dnd-global/hardware-esp32-ethernet/docs/img/3d-cheo-sau.jpg

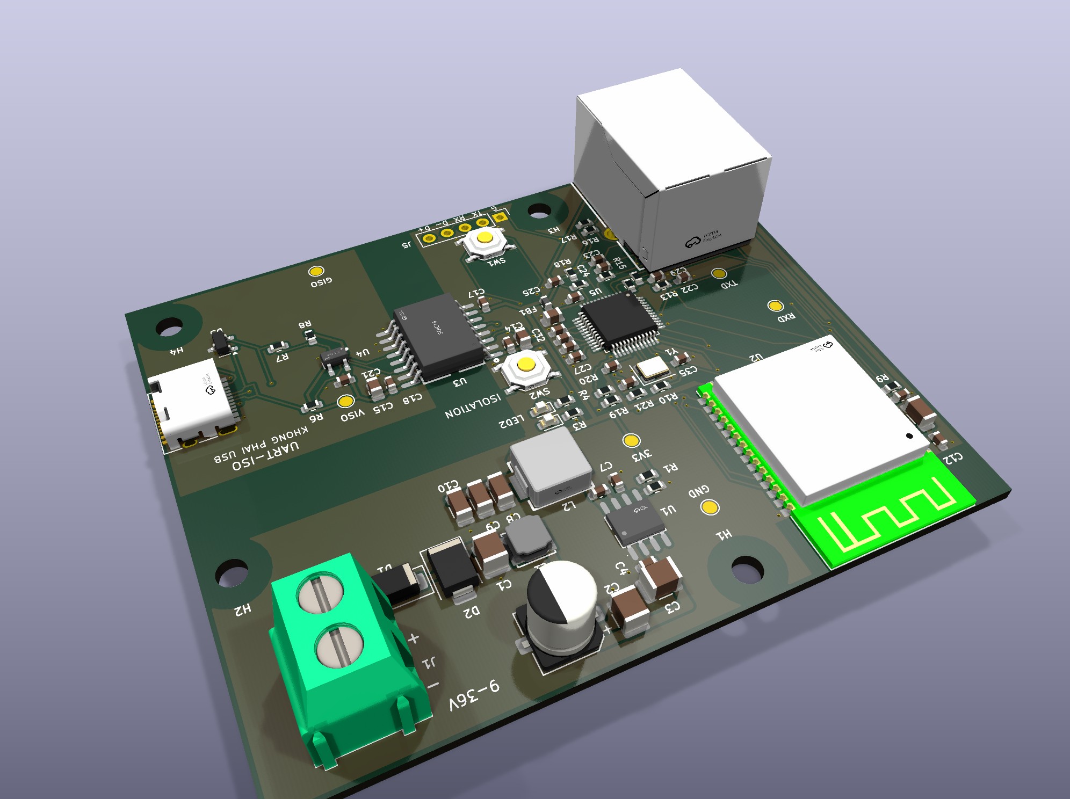
docs/img/3d-cheo-sau.jpg
