dnd-global/hardware-esp32-ethernet/docs/img/3d-mat-duoi.jpg

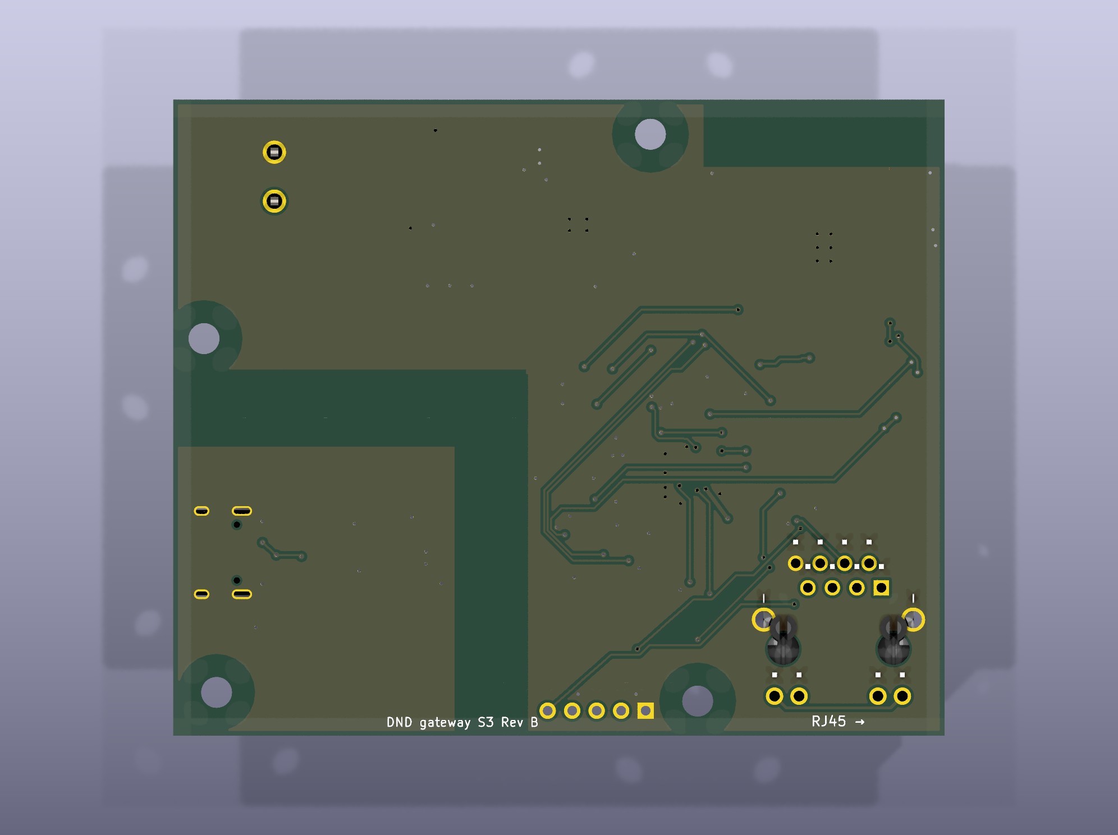
docs/img/3d-mat-duoi.jpg
