dnd-global/hardware-esp32-ethernet/fab/gateway-s3-revb-bom.csv

Comment | Designator | Footprint | LCSC Part #
4.7uF 100V | C1,C2,C3 | C_1210_3225Metric | C381466
22nF | C22 | C_0603_1608Metric | C21122
6.8nF | C23,C24 | C_0603_1608Metric | C1631
4.7uF | C26 | C_0603_1608Metric | C19666
10nF | C27,C25 | C_0603_1608Metric | C57112
10uF | C32,C14,C15 | C_0805_2012Metric | C15850
18pF | C34,C35 | C_0603_1608Metric | C1647
220nF 100V | C4 | C_0603_1608Metric | C36911431
47uF 63V | C5 | CP_Elec_6.3x7.7 | C48971005
100nF | C6,C12,C28,C29,C30,C31,C33,C16,C18,C21 | C_0603_1608Metric | C14663
1uF | C7,C13,C17 | C_0603_1608Metric | C15849
22uF 25V | C8,C9,C10,C11 | C_1206_3216Metric | C12891
SS210 | D1 | D_SMA | C14996
SMBJ36A | D2 | D_SMB | C353364
PESD5V0S2BT | D3 | SOT-23 | C49338
PTC 0.5A 60V | F1 | F1812 | C70113
120R@100MHz | FB1 | L_0603_1608Metric | C14709
KF128-5.08-2P (+ / -) | J1 | CONN-TH_2P-P5.08_KF128-5.08-2P | C474952
HR911105A | J3 | RJ45-TH_HR911105A | C12074
UART-ISO | J6 | USB_C_Receptacle_HRO_TYPE-C-31-M-12 | C165948
10uH | L1 | IND-SMD_L4.0-W4.0 | C38117
6.8uH 4A | L2 | IND-SMD_L7.0-W6.6 | C357230
PWR red | LED1 | LED_0603_1608Metric | C2286
STATUS white | LED2 | LED_0603_1608Metric | C2290
51k | R1 | R_0603_1608Metric | C23196
1M | R10 | R_0603_1608Metric | C22935
49.9R 1% | R11,R12,R14,R15 | R_0603_1608Metric | C23185
10R | R13 | R_0603_1608Metric | C22859
330R | R16,R17 | R_0603_1608Metric | C23138
12.4k 1% | R18 | R_0603_1608Metric | C2930060
22k | R2 | R_0603_1608Metric | C31850
1k | R3 | R_0603_1608Metric | C21190
150R | R4 | R_0603_1608Metric | C22808
100R | R6 | R_0603_1608Metric | C22775
220R | R7 | R_0603_1608Metric | C22962
10k | R9,R19,R20,R21,R8 | R_0603_1608Metric | C25804
RESET / BOOT | SW1,SW2 | SW-SMD_4P-L5.1-W5.1-P3.70-LS6.5-TL_H1.5 | C318884
LMR36520 | U1 | POWERPAD-SO-8_L4.9-W3.9-P1.27-LS6.0-BL-EP | C1858395
ESP32-S3-WROOM-1-N8 | U2 | WIFIM-SMD_ESP32-S3-WROOM-1-N8 | C2913198
CA-IS3642HVW | U3 | SOIC-16_L10.3-W7.5-P1.27-LS10.3-TL | C5440874
SN74LVC1G17DBVR | U4 | SOT-25-5_L3.0-W1.8-P0.95-LS3.0-BL | C7836
W5500 | U5 | LQFP-48_7x7mm_P0.5mm | C32843
25MHz 12pF | Y1 | Crystal_SMD_3225-4Pin_3.2x2.5mm | C9006
