dnd-global/hardware-esp32-ethernet/kicad/esp32-eth-uart-module.kicad_pcb

## KiCad design kicad/esp32-eth-uart-module.kicad_pcb (2026-11-11)

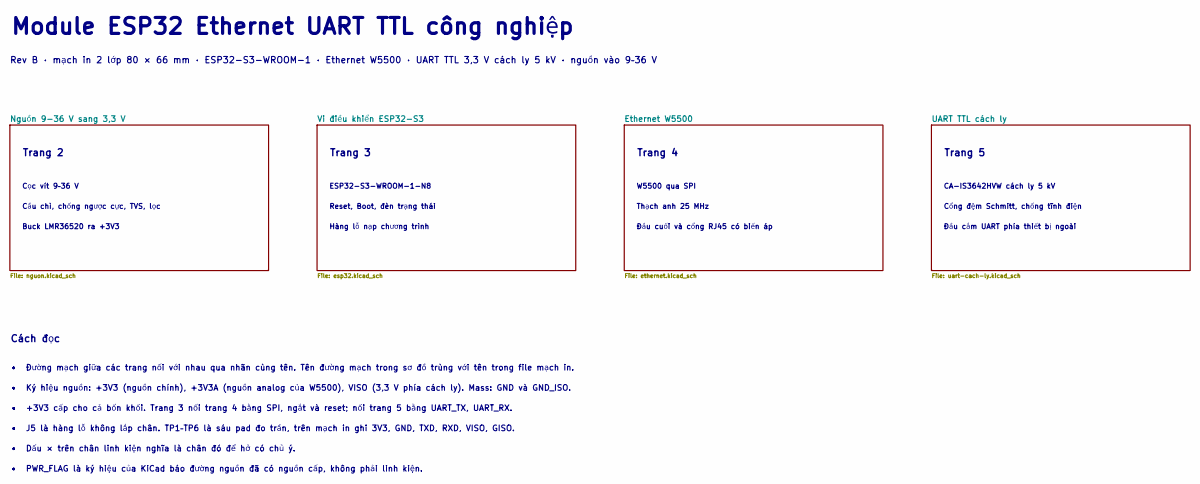
[picture p15: schematic esp32-eth-uart-module.kicad_sch, Module ESP32 Ethernet UART TTL công nghiệp]

Notes on the sheet:
Module ESP32 Ethernet UART TTL công nghiệp
Rev B · mạch in 2 lớp 80 × 66 mm · ESP32-S3-WROOM-1 · Ethernet W5500 · UART TTL 3,3 V cách ly 5 kV · nguồn vào 9–36 V
Trang 2
Cọc vít 9–36 V
Cầu chì, chống ngược cực, TVS, lọc
Buck LMR36520 ra +3V3
Trang 3
ESP32-S3-WROOM-1-N8
Reset, Boot, đèn trạng thái
Hàng lỗ nạp chương trình
Trang 4
W5500 qua SPI
Thạch anh 25 MHz
Đầu cuối và cổng RJ45 có biến áp
Trang 5
CA-IS3642HVW cách ly 5 kV
Cổng đệm Schmitt, chống tĩnh điện
Đầu cắm UART phía thiết bị ngoài
Cách đọc
• Đường mạch giữa các trang nối với nhau qua nhãn cùng tên. Tên đường mạch trong sơ đồ trùng với tên trong file mạch in.
• Ký hiệu nguồn: +3V3 (nguồn chính), +3V3A (nguồn analog của W5500), VISO (3,3 V phía cách ly). Mass: GND và GND_ISO.
• +3V3 cấp cho cả bốn khối. Trang 3 nối trang 4 bằng SPI, ngắt và reset; nối trang 5 bằng UART_TX, UART_RX.
• J5 là hàng lỗ không lắp chân. TP1–TP6 là sáu pad đo trần, trên mạch in ghi 3V3, GND, TXD, RXD, VISO, GISO.
• Dấu × trên chân linh kiện nghĩa là chân đó để hở có chủ ý.
• PWR_FLAG là ký hiệu của KiCad báo đường nguồn đã có nguồn cấp, không phải linh kiện.

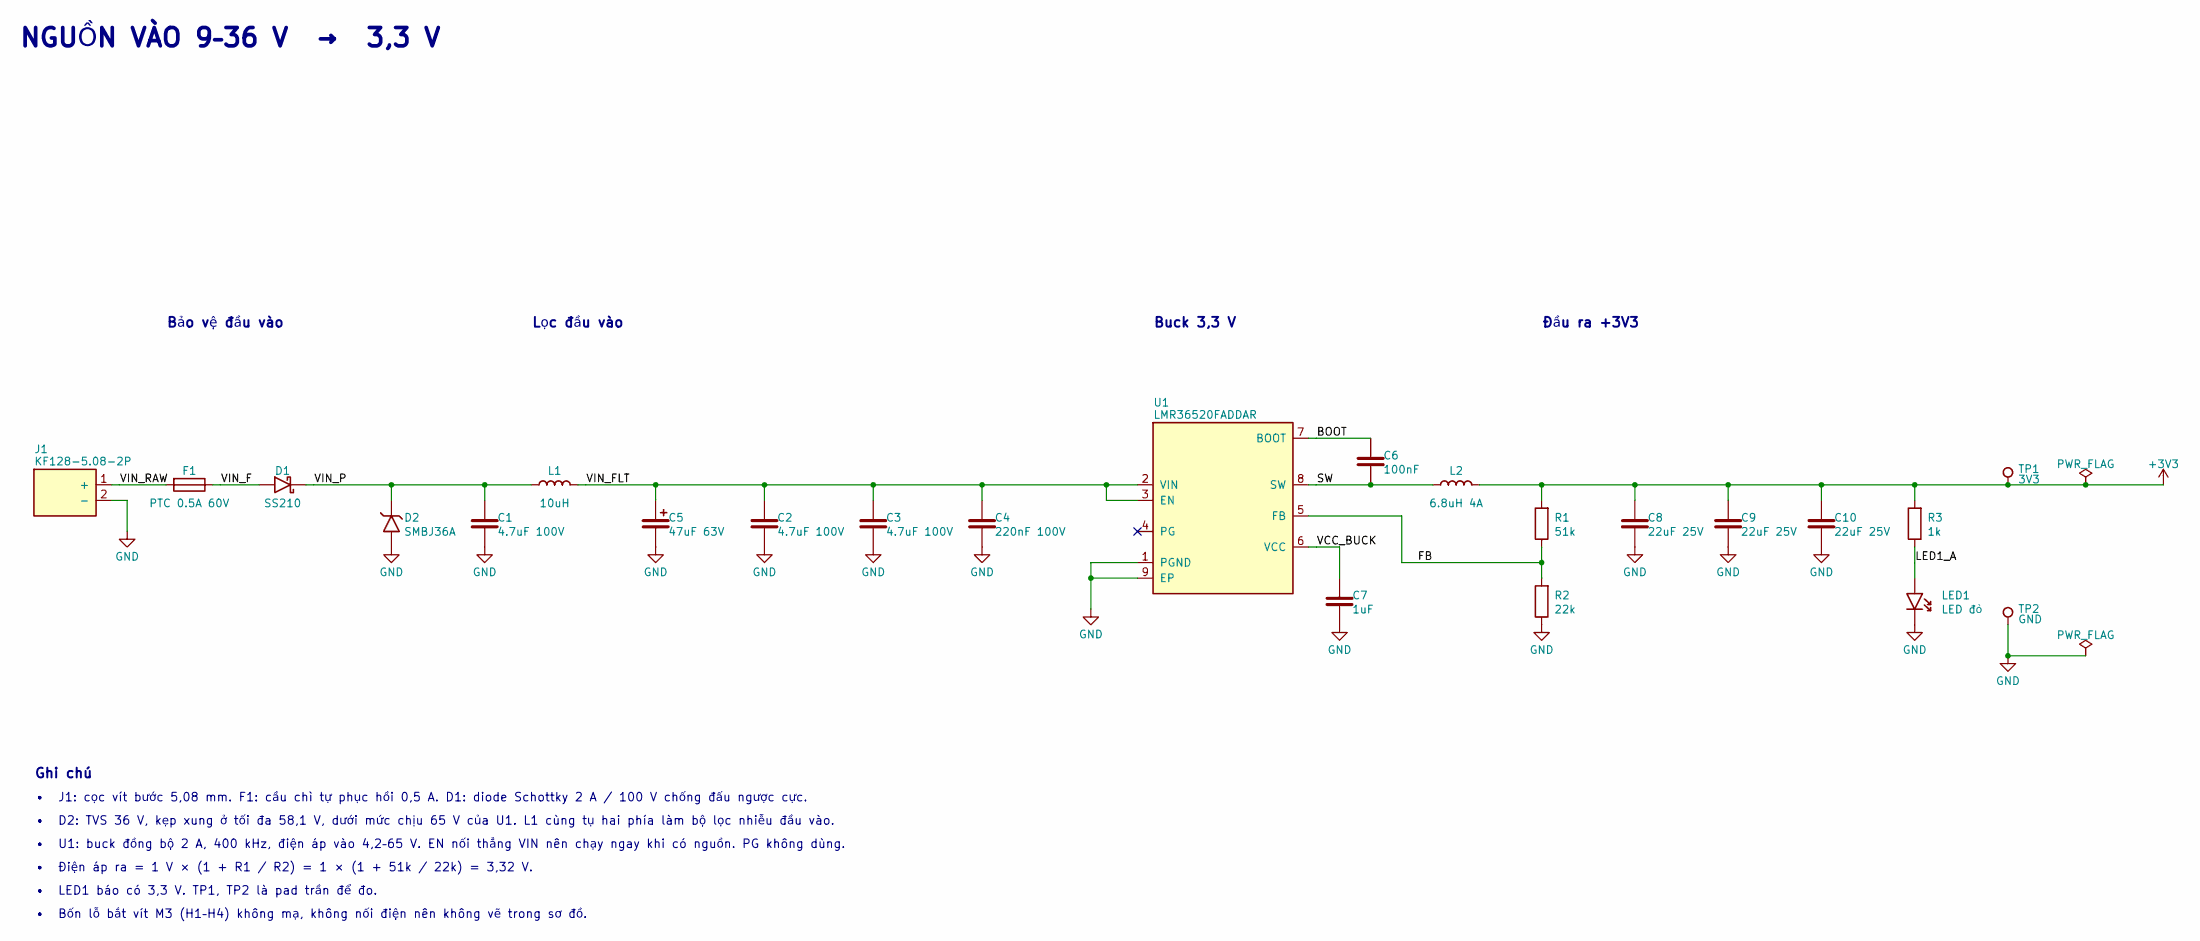
[picture p16: schematic nguon.kicad_sch, Module ESP32 Ethernet UART TTL công nghiệp]

Parts:
C1, C2, C3: 4.7uF 100V; C_1210_3225Metric; LCSC C381466
C4: 220nF 100V; C_0603_1608Metric; LCSC C36911431
C5: 47uF 63V; CP_Elec_6.3x7.7; LCSC C48971005
C6: 100nF; C_0603_1608Metric; LCSC C14663
C7: 1uF; C_0603_1608Metric; LCSC C15849
C8, C9, C10: 22uF 25V; C_1206_3216Metric; LCSC C12891
D1: SS210; D_SMA; LCSC C14996
D2: SMBJ36A; D_SMB; LCSC C353364
F1: PTC 0.5A 60V; F1812; LCSC C70113
J1: KF128-5.08-2P; CONN-TH_2P-P5.08_KF128-5.08-2P; LCSC C474952
L1: 10uH; IND-SMD_L4.0-W4.0; LCSC C38117
L2: 6.8uH 4A; IND-SMD_L7.0-W6.6; LCSC C357230
LED1: LED đỏ; LED_0603_1608Metric; LCSC C2286
R1: 51k; R_0603_1608Metric; LCSC C23196
R2: 22k; R_0603_1608Metric; LCSC C31850
R3: 1k; R_0603_1608Metric; LCSC C21190
TP1: 3V3; TestPoint_Pad_D1.5mm
TP2: GND; TestPoint_Pad_D1.5mm
U1: LMR36520FADDAR; POWERPAD-SO-8_L4.9-W3.9-P1.27-LS6.0-BL-EP; LCSC C1858395

Connections:
+3V3: C8.1, C9.1, C10.1, L2.2, R1.1, R3.1, TP1.1; also elsewhere on the board
BOOT: C6.1, U1.7 (BOOT)
FB: R1.2, R2.1, U1.5 (FB)
GND: C1.2, C2.2, C3.2, C4.2, C5.2, C7.2, C8.2, C9.2, C10.2, D2.2, J1.2 (-), LED1.1, R2.2, TP2.1, U1.1 (PGND), U1.9 (EP); also elsewhere on the board
LED1_A: LED1.2, R3.2
PG: U1.4 (PG)
SW: C6.2, L2.1, U1.8 (SW)
VCC_BUCK: C7.1, U1.6 (VCC)
VIN_F: D1.2, F1.1
VIN_FLT: C2.1, C3.1, C4.1, C5.1, L1.2, U1.2 (VIN), U1.3 (EN)
VIN_P: C1.1, D1.1, D2.1, L1.1
VIN_RAW: F1.2, J1.1 (+)

Notes on the sheet:
NGUỒN VÀO 9–36 V → 3,3 V
Bảo vệ đầu vào
Lọc đầu vào
Buck 3,3 V
Đầu ra +3V3
Ghi chú
• J1: cọc vít bước 5,08 mm. F1: cầu chì tự phục hồi 0,5 A. D1: diode Schottky 2 A / 100 V chống đấu ngược cực.
• D2: TVS 36 V, kẹp xung ở tối đa 58,1 V, dưới mức chịu 65 V của U1. L1 cùng tụ hai phía làm bộ lọc nhiễu đầu vào.
• U1: buck đồng bộ 2 A, 400 kHz, điện áp vào 4,2–65 V. EN nối thẳng VIN nên chạy ngay khi có nguồn. PG không dùng.
• Điện áp ra = 1 V × (1 + R1 / R2) = 1 × (1 + 51k / 22k) = 3,32 V.
• LED1 báo có 3,3 V. TP1, TP2 là pad trần để đo.
• Bốn lỗ bắt vít M3 (H1–H4) không mạ, không nối điện nên không vẽ trong sơ đồ.

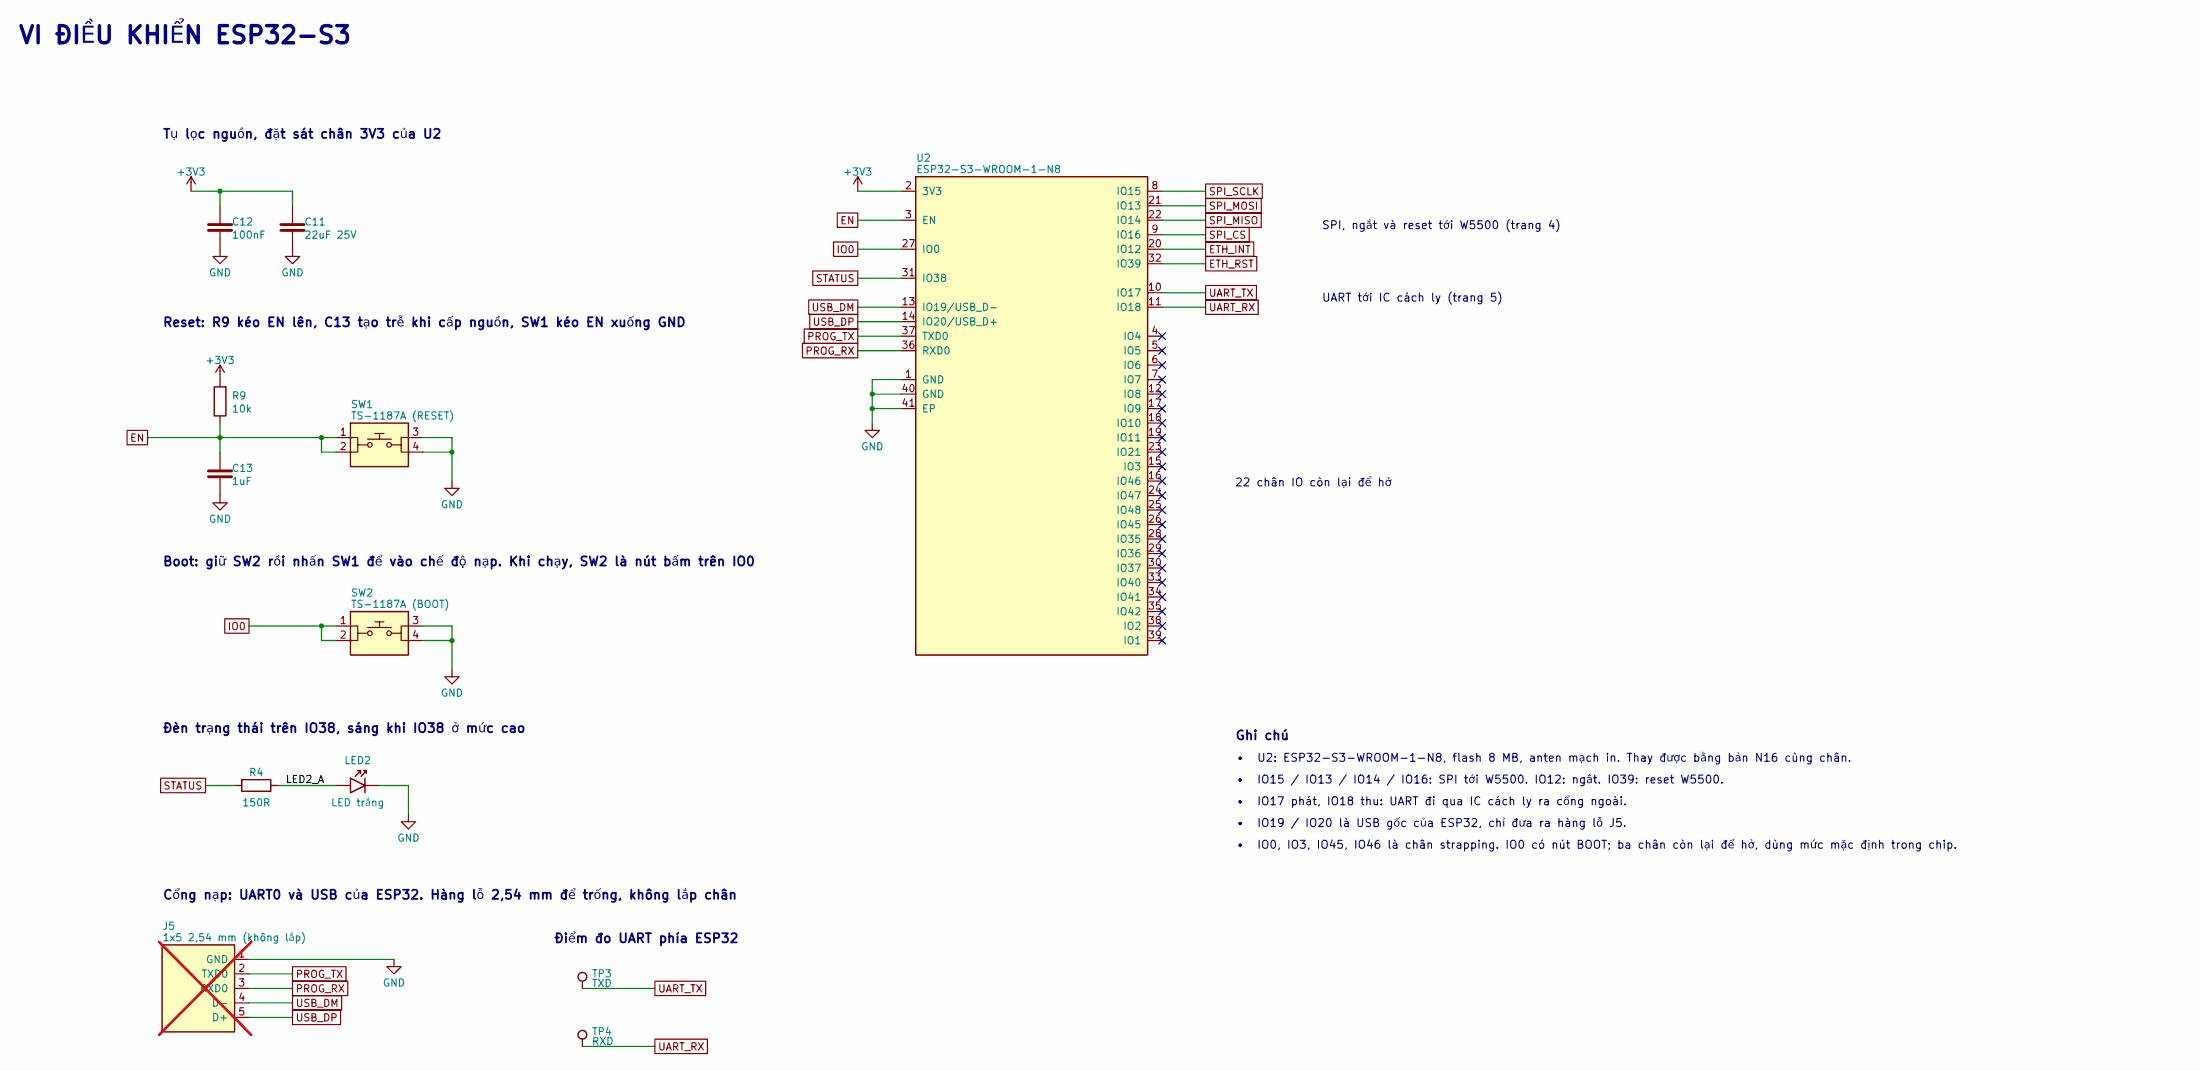
[picture p17: schematic esp32.kicad_sch, Module ESP32 Ethernet UART TTL công nghiệp]

Parts:
C11: 22uF 25V; C_1206_3216Metric; LCSC C12891
C12: 100nF; C_0603_1608Metric; LCSC C14663
C13: 1uF; C_0603_1608Metric; LCSC C15849
J5: 1x5 2,54 mm (không lắp); PinHeader_1x05_P2.54mm_Vertical; not fitted
LED2: LED trắng; LED_0603_1608Metric; LCSC C2290
R4: 150R; R_0603_1608Metric; LCSC C22808
R9: 10k; R_0603_1608Metric; LCSC C25804
SW1: TS-1187A (RESET); SW-SMD_4P-L5.1-W5.1-P3.70-LS6.5-TL_H1.5; LCSC C318884
SW2: TS-1187A (BOOT); SW-SMD_4P-L5.1-W5.1-P3.70-LS6.5-TL_H1.5; LCSC C318884
TP3: TXD; TestPoint_Pad_D1.5mm
TP4: RXD; TestPoint_Pad_D1.5mm
U2: ESP32-S3-WROOM-1-N8; WIFIM-SMD_ESP32-S3-WROOM-1-N8; LCSC C2913198

Connections:
+3V3: C11.1, C12.1, R9.1, U2.2 (3V3); also elsewhere on the board
EN: C13.1, R9.2, SW1.1, SW1.2, U2.3 (EN)
ETH_INT: U2.20 (IO12); also elsewhere on the board
ETH_RST: U2.32 (IO39); also elsewhere on the board
GND: C11.2, C12.2, C13.2, J5.1 (GND), LED2.1, SW1.3, SW1.4, SW2.3, SW2.4, U2.1 (GND), U2.40 (GND), U2.41 (EP); also elsewhere on the board
IO0: SW2.1, SW2.2, U2.27 (IO0)
LED2_A: LED2.2, R4.2
PROG_RX: J5.3 (RXD0), U2.36 (RXD0)
PROG_TX: J5.2 (TXD0), U2.37 (TXD0)
SPI_CS: U2.9 (IO16); also elsewhere on the board
SPI_MISO: U2.22 (IO14); also elsewhere on the board
SPI_MOSI: U2.21 (IO13); also elsewhere on the board
SPI_SCLK: U2.8 (IO15); also elsewhere on the board
STATUS: R4.1, U2.31 (IO38)
UART_RX: TP4.1, U2.11 (IO18); also elsewhere on the board
UART_TX: TP3.1, U2.10 (IO17); also elsewhere on the board
USB_DM: J5.4 (D-), U2.13 (IO19/USB_D-)
USB_DP: J5.5 (D+), U2.14 (IO20/USB_D+)

Notes on the sheet:
VI ĐIỀU KHIỂN ESP32-S3
SPI, ngắt và reset tới W5500 (trang 4)
UART tới IC cách ly (trang 5)
22 chân IO còn lại để hở
Tụ lọc nguồn, đặt sát chân 3V3 của U2
Reset: R9 kéo EN lên, C13 tạo trễ khi cấp nguồn, SW1 kéo EN xuống GND
Boot: giữ SW2 rồi nhấn SW1 để vào chế độ nạp. Khi chạy, SW2 là nút bấm trên IO0
Đèn trạng thái trên IO38, sáng khi IO38 ở mức cao
Cổng nạp: UART0 và USB của ESP32. Hàng lỗ 2,54 mm để trống, không lắp chân
Điểm đo UART phía ESP32
Ghi chú
• U2: ESP32-S3-WROOM-1-N8, flash 8 MB, anten mạch in. Thay được bằng bản N16 cùng chân.
• IO15 / IO13 / IO14 / IO16: SPI tới W5500. IO12: ngắt. IO39: reset W5500.
• IO17 phát, IO18 thu: UART đi qua IC cách ly ra cổng ngoài.
• IO19 / IO20 là USB gốc của ESP32, chỉ đưa ra hàng lỗ J5.
• IO0, IO3, IO45, IO46 là chân strapping. IO0 có nút BOOT; ba chân còn lại để hở, dùng mức mặc định trong chip.

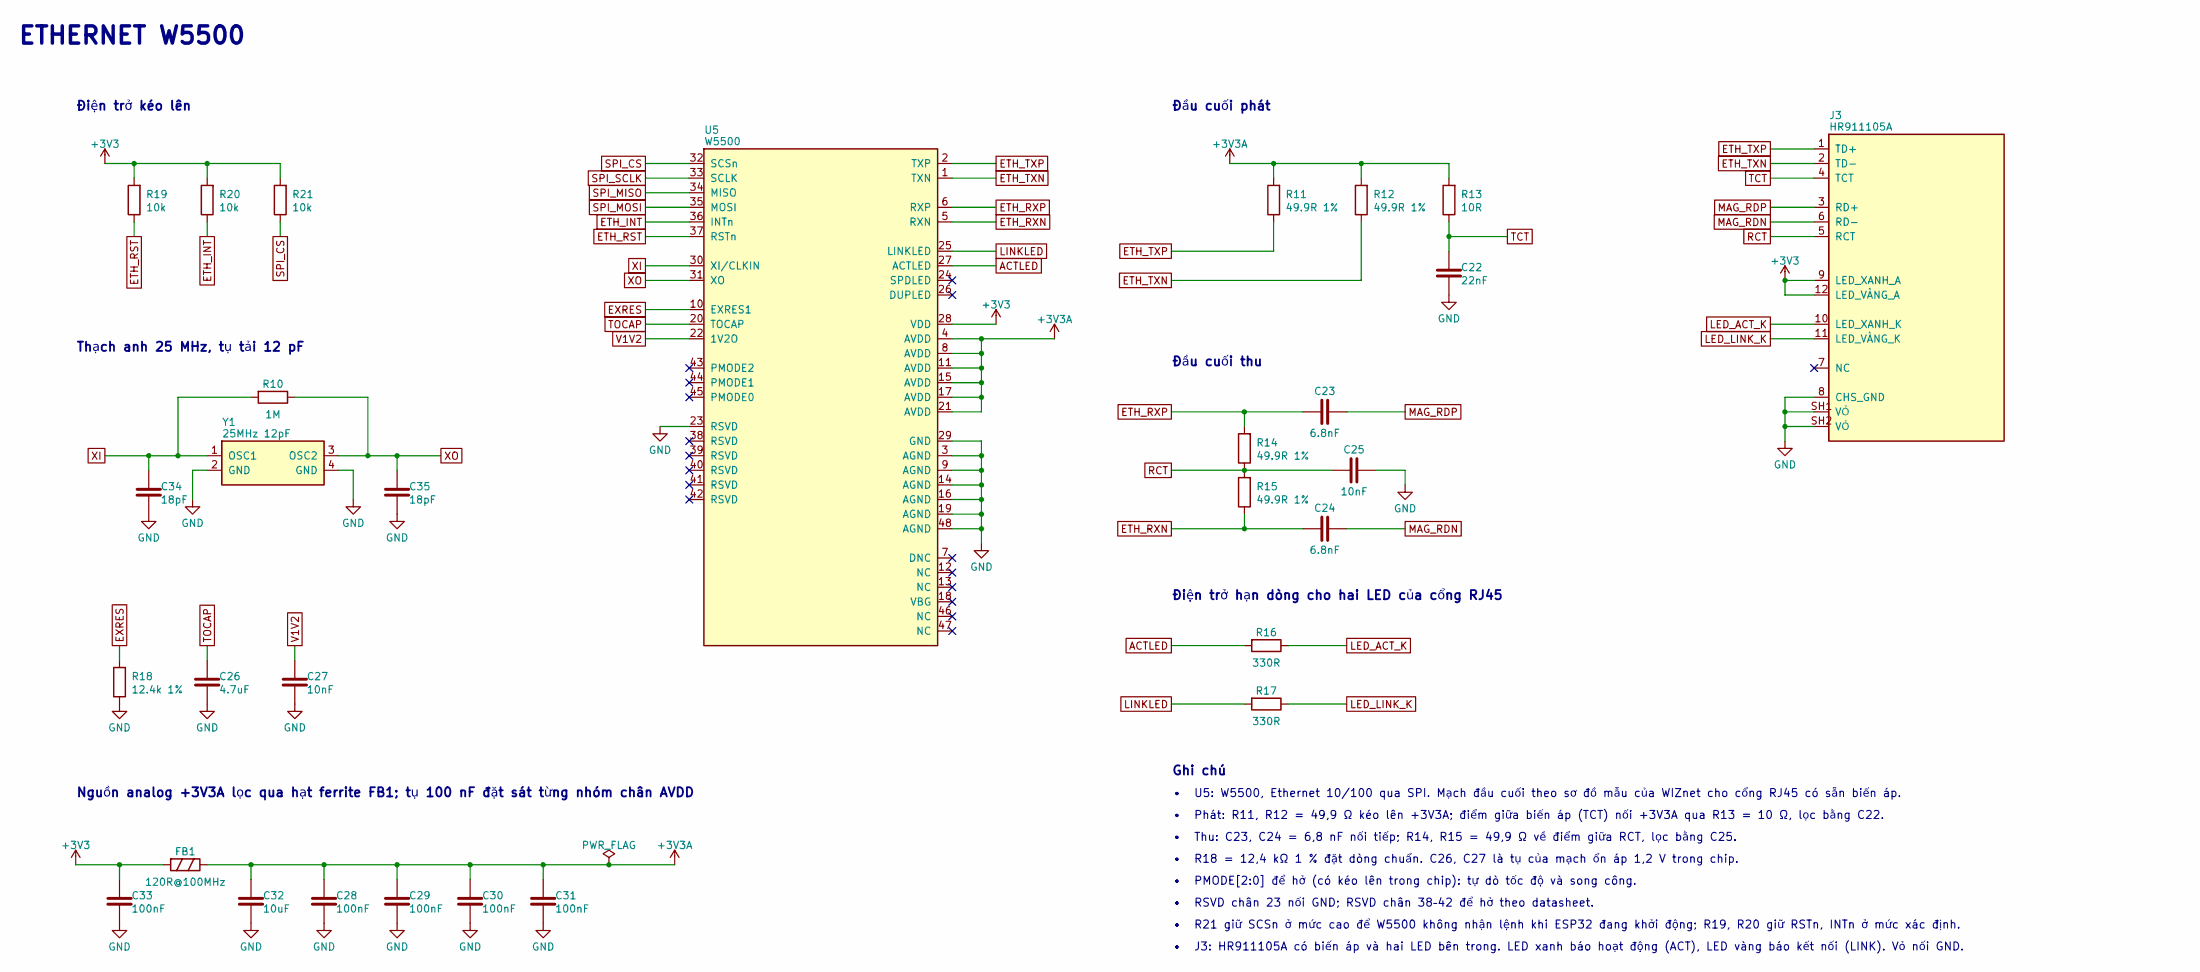
[picture p18: schematic ethernet.kicad_sch, Module ESP32 Ethernet UART TTL công nghiệp]

Parts:
C22: 22nF; C_0603_1608Metric; LCSC C21122
C23, C24: 6.8nF; C_0603_1608Metric; LCSC C1631
C25, C27: 10nF; C_0603_1608Metric; LCSC C57112
C26: 4.7uF; C_0603_1608Metric; LCSC C19666
C28, C29, C30, C31, C33: 100nF; C_0603_1608Metric; LCSC C14663
C32: 10uF; C_0805_2012Metric; LCSC C15850
C34, C35: 18pF; C_0603_1608Metric; LCSC C1647
FB1: 120R@100MHz; L_0603_1608Metric; LCSC C14709
J3: HR911105A; RJ45-TH_HR911105A; LCSC C12074
R10: 1M; R_0603_1608Metric; LCSC C22935
R11, R12, R14, R15: 49.9R 1%; R_0603_1608Metric; LCSC C23185
R13: 10R; R_0603_1608Metric; LCSC C22859
R16, R17: 330R; R_0603_1608Metric; LCSC C23138
R18: 12.4k 1%; R_0603_1608Metric; LCSC C2930060
R19, R20, R21: 10k; R_0603_1608Metric; LCSC C25804
U5: W5500; LQFP-48_7x7mm_P0.5mm; LCSC C32843
Y1: 25MHz 12pF; Crystal_SMD_3225-4Pin_3.2x2.5mm; LCSC C9006

Connections:
+3V3: C33.1, FB1.1, J3.9 (LED_XANH_A), J3.12 (LED_VÀNG_A), R19.1, R20.1, R21.1, U5.28 (VDD); also elsewhere on the board
+3V3A: C28.1, C29.1, C30.1, C31.1, C32.1, FB1.2, R11.1, R12.1, R13.1, U5.4 (AVDD), U5.8 (AVDD), U5.11 (AVDD), U5.15 (AVDD), U5.17 (AVDD), U5.21 (AVDD)
ACTLED: R16.2, U5.27 (ACTLED)
ETH_INT: R20.2, U5.36 (INTn); also elsewhere on the board
ETH_RST: R19.2, U5.37 (RSTn); also elsewhere on the board
ETH_RXN: C24.1, R15.1, U5.5 (RXN)
ETH_RXP: C23.1, R14.1, U5.6 (RXP)
ETH_TXN: J3.2 (TD-), R12.2, U5.1 (TXN)
ETH_TXP: J3.1 (TD+), R11.2, U5.2 (TXP)
EXRES: R18.1, U5.10 (EXRES1)
GND: C22.2, C25.2, C26.2, C27.2, C28.2, C29.2, C30.2, C31.2, C32.2, C33.2, C34.2, C35.2, J3.8 (CHS_GND), J3.SH1 (VỎ), J3.SH2 (VỎ), R18.2, U5.3 (AGND), U5.9 (AGND), U5.14 (AGND), U5.16 (AGND), U5.19 (AGND), U5.23 (RSVD), U5.29 (GND), U5.48 (AGND), Y1.2 (GND), Y1.4 (GND); also elsewhere on the board
LED_ACT_K: J3.10 (LED_XANH_K), R16.1
LED_LINK_K: J3.11 (LED_VÀNG_K), R17.1
LINKLED: R17.2, U5.25 (LINKLED)
MAG_RDN: C24.2, J3.6 (RD-)
MAG_RDP: C23.2, J3.3 (RD+)
RCT: C25.1, J3.5 (RCT), R14.2, R15.2
SPI_CS: R21.2, U5.32 (SCSn); also elsewhere on the board
SPI_MISO: U5.34 (MISO); also elsewhere on the board
SPI_MOSI: U5.35 (MOSI); also elsewhere on the board
SPI_SCLK: U5.33 (SCLK); also elsewhere on the board
TCT: C22.1, J3.4 (TCT), R13.2
TOCAP: C26.1, U5.20 (TOCAP)
V1V2: C27.1, U5.22 (1V2O)
XI: C34.1, R10.1, U5.30 (XI/CLKIN), Y1.1 (OSC1)
XO: C35.1, R10.2, U5.31 (XO), Y1.3 (OSC2)

Notes on the sheet:
ETHERNET W5500
Điện trở kéo lên
Thạch anh 25 MHz, tụ tải 12 pF
Nguồn analog +3V3A lọc qua hạt ferrite FB1; tụ 100 nF đặt sát từng nhóm chân AVDD
Đầu cuối phát
Đầu cuối thu
Điện trở hạn dòng cho hai LED của cổng RJ45
Ghi chú
• U5: W5500, Ethernet 10/100 qua SPI. Mạch đầu cuối theo sơ đồ mẫu của WIZnet cho cổng RJ45 có sẵn biến áp.
• Phát: R11, R12 = 49,9 Ω kéo lên +3V3A; điểm giữa biến áp (TCT) nối +3V3A qua R13 = 10 Ω, lọc bằng C22.
• Thu: C23, C24 = 6,8 nF nối tiếp; R14, R15 = 49,9 Ω về điểm giữa RCT, lọc bằng C25.
• R18 = 12,4 kΩ 1 % đặt dòng chuẩn. C26, C27 là tụ của mạch ổn áp 1,2 V trong chip.
• PMODE[2:0] để hở (có kéo lên trong chip): tự dò tốc độ và song công.
• RSVD chân 23 nối GND; RSVD chân 38–42 để hở theo datasheet.
• R21 giữ SCSn ở mức cao để W5500 không nhận lệnh khi ESP32 đang khởi động; R19, R20 giữ RSTn, INTn ở mức xác định.
• J3: HR911105A có biến áp và hai LED bên trong. LED xanh báo hoạt động (ACT), LED vàng báo kết nối (LINK). Vỏ nối GND.

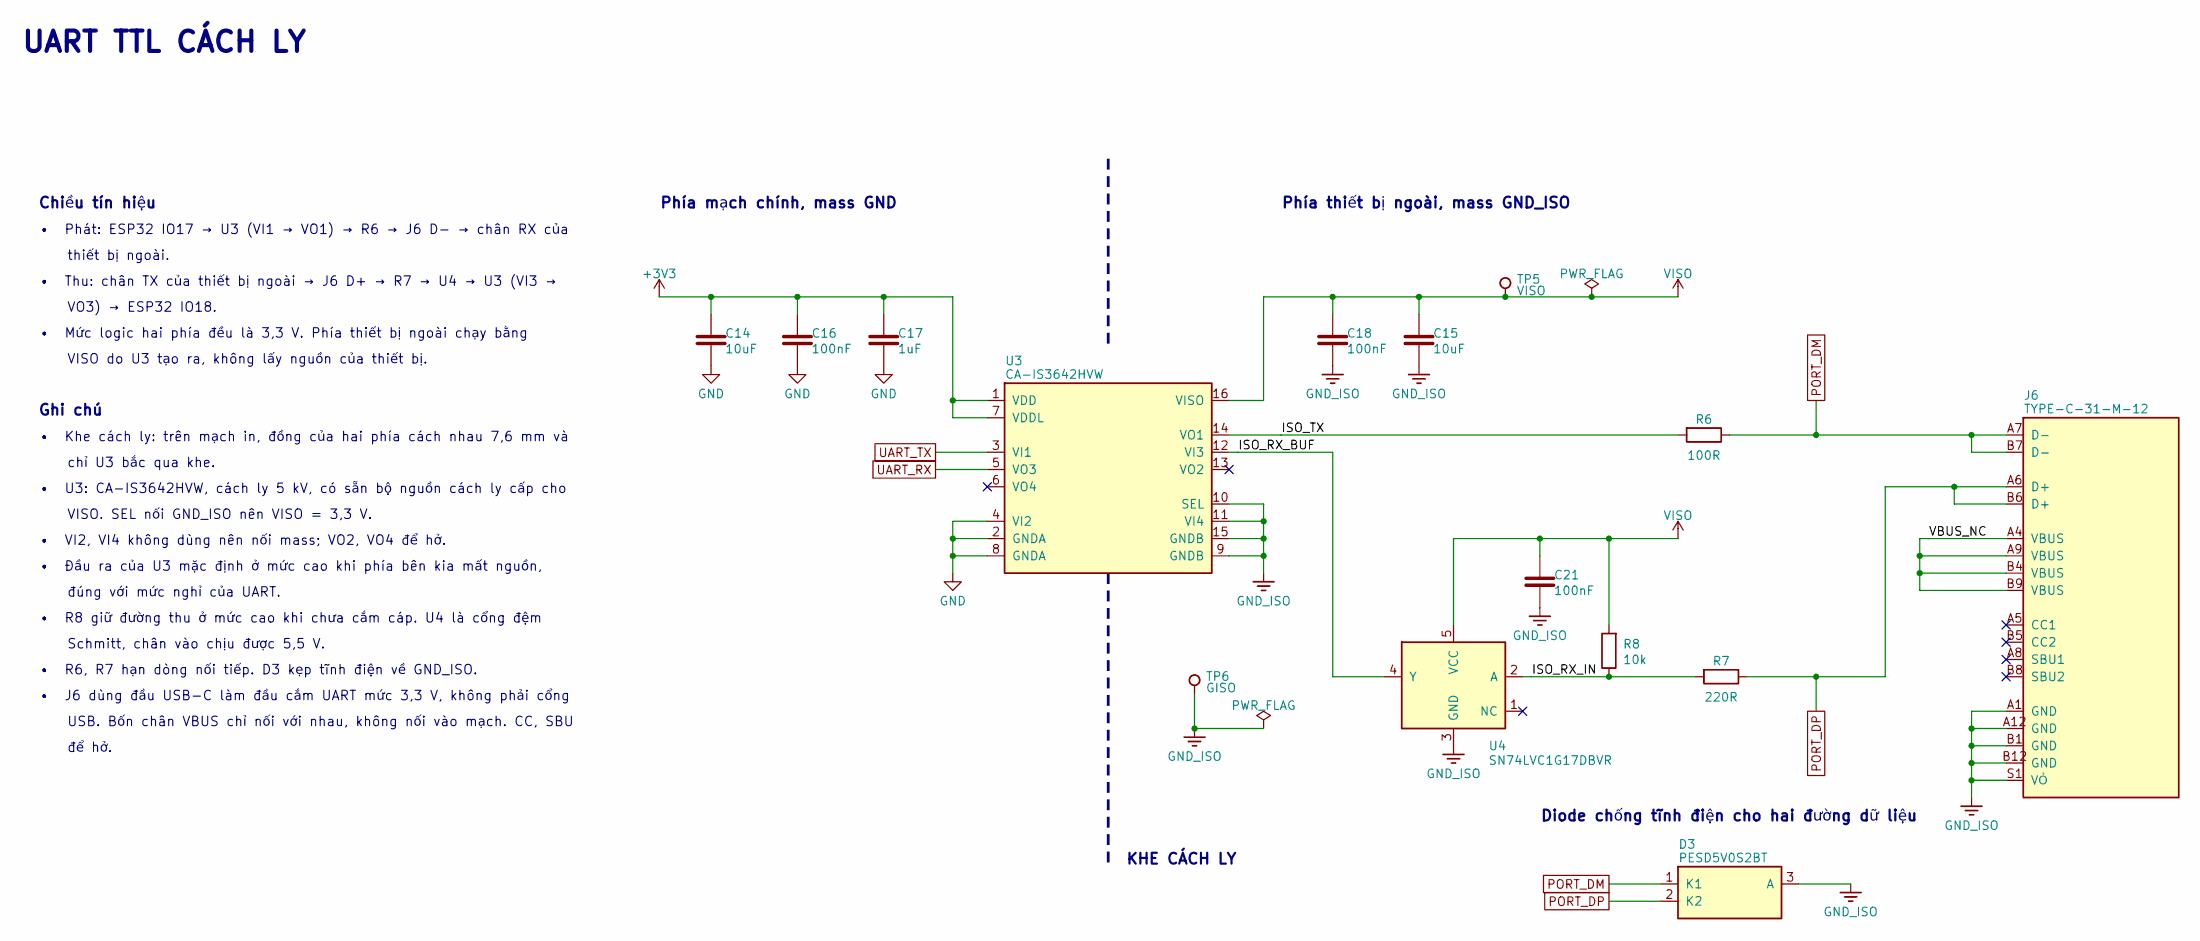
[picture p19: schematic uart-cach-ly.kicad_sch, Module ESP32 Ethernet UART TTL công nghiệp]

Parts:
C14, C15: 10uF; C_0805_2012Metric; LCSC C15850
C16, C18, C21: 100nF; C_0603_1608Metric; LCSC C14663
C17: 1uF; C_0603_1608Metric; LCSC C15849
D3: PESD5V0S2BT; SOT-23; LCSC C49338
J6: TYPE-C-31-M-12; USB_C_Receptacle_HRO_TYPE-C-31-M-12; LCSC C165948
R6: 100R; R_0603_1608Metric; LCSC C22775
R7: 220R; R_0603_1608Metric; LCSC C22962
R8: 10k; R_0603_1608Metric; LCSC C25804
TP5: VISO; TestPoint_Pad_D1.5mm
TP6: GISO; TestPoint_Pad_D1.5mm
U3: CA-IS3642HVW; SOIC-16_L10.3-W7.5-P1.27-LS10.3-TL; LCSC C5440874
U4: SN74LVC1G17DBVR; SOT-25-5_L3.0-W1.8-P0.95-LS3.0-BL; LCSC C7836

Connections:
+3V3: C14.1, C16.1, C17.1, U3.1 (VDD), U3.7 (VDDL); also elsewhere on the board
GND: C14.2, C16.2, C17.2, U3.2 (GNDA), U3.4 (VI2), U3.8 (GNDA); also elsewhere on the board
GND_ISO: C15.2, C18.2, C21.2, D3.3 (A), J6.A1 (GND), J6.A12 (GND), J6.B1 (GND), J6.B12 (GND), J6.S1 (VỎ), TP6.1, U3.9 (GNDB), U3.10 (SEL), U3.11 (VI4), U3.15 (GNDB), U4.3 (GND); also elsewhere on the board
ISO_RX_BUF: U3.12 (VI3), U4.4 (Y)
ISO_RX_IN: R7.2, R8.2, U4.2 (A)
ISO_TX: R6.1, U3.14 (VO1)
PORT_DM: D3.1 (K1), J6.A7 (D-), J6.B7 (D-), R6.2
PORT_DP: D3.2 (K2), J6.A6 (D+), J6.B6 (D+), R7.1
UART_RX: U3.5 (VO3); also elsewhere on the board
UART_TX: U3.3 (VI1); also elsewhere on the board
VBUS_NC: J6.A4 (VBUS), J6.A9 (VBUS), J6.B4 (VBUS), J6.B9 (VBUS)
VISO: C15.1, C18.1, C21.1, R8.1, TP5.1, U3.16 (VISO), U4.5 (VCC); also elsewhere on the board

Notes on the sheet:
UART TTL CÁCH LY
Diode chống tĩnh điện cho hai đường dữ liệu
KHE CÁCH LY
Phía mạch chính, mass GND
Phía thiết bị ngoài, mass GND_ISO
Chiều tín hiệu
• Phát: ESP32 IO17 → U3 (VI1 → VO1) → R6 → J6 D− → chân RX của
thiết bị ngoài.
• Thu: chân TX của thiết bị ngoài → J6 D+ → R7 → U4 → U3 (VI3 →
VO3) → ESP32 IO18.
• Mức logic hai phía đều là 3,3 V. Phía thiết bị ngoài chạy bằng
VISO do U3 tạo ra, không lấy nguồn của thiết bị.
Ghi chú
• Khe cách ly: trên mạch in, đồng của hai phía cách nhau 7,6 mm và
chỉ U3 bắc qua khe.
• U3: CA-IS3642HVW, cách ly 5 kV, có sẵn bộ nguồn cách ly cấp cho
VISO. SEL nối GND_ISO nên VISO = 3,3 V.
• VI2, VI4 không dùng nên nối mass; VO2, VO4 để hở.
• Đầu ra của U3 mặc định ở mức cao khi phía bên kia mất nguồn,
đúng với mức nghỉ của UART.
• R8 giữ đường thu ở mức cao khi chưa cắm cáp. U4 là cổng đệm
Schmitt, chân vào chịu được 5,5 V.
• R6, R7 hạn dòng nối tiếp. D3 kẹp tĩnh điện về GND_ISO.
• J6 dùng đầu USB-C làm đầu cắm UART mức 3,3 V, không phải cổng
USB. Bốn chân VBUS chỉ nối với nhau, không nối vào mạch. CC, SBU
để hở.

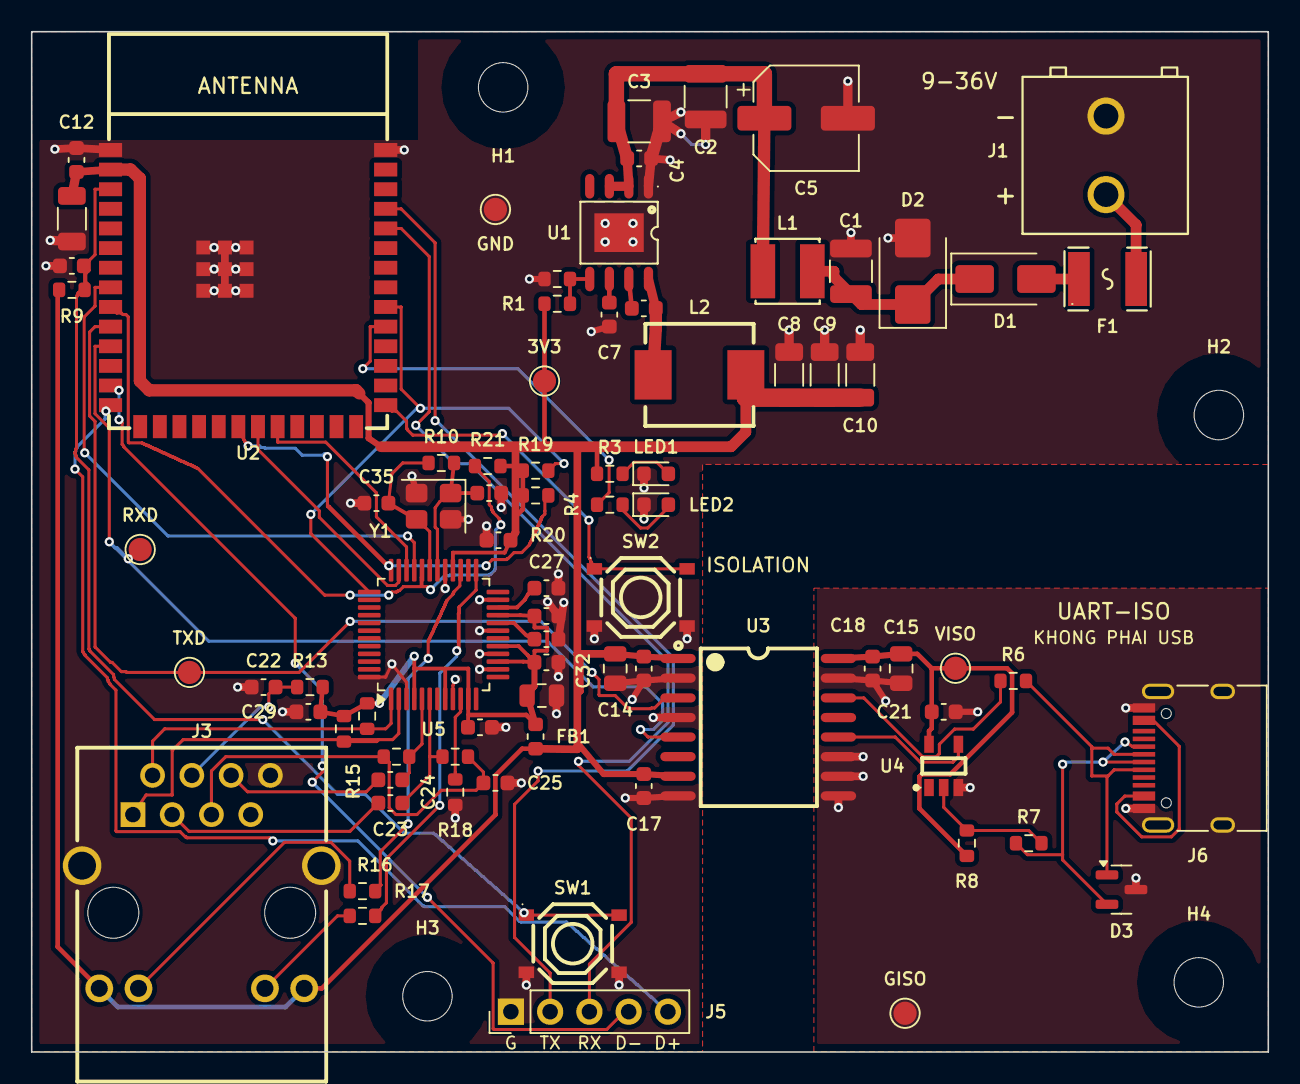
[picture p20: board esp32-eth-uart-module.kicad_pcb from above]

Board: 2 copper layers, 80.0 x 66.0 mm, 84 parts (0 on the bottom side), 53 nets.

Other parts of the board:
3V3: test point +3V3; TestPoint_Pad_D1.5mm
GISO: test point GND_ISO; TestPoint_Pad_D1.5mm
GND: test point GND; TestPoint_Pad_D1.5mm
H1, H2, H3, H4: MountingHole_3.2mm_M3
RXD: test point UART_RX; TestPoint_Pad_D1.5mm
TXD: test point UART_TX; TestPoint_Pad_D1.5mm
VISO: test point VISO; TestPoint_Pad_D1.5mm

Their connections:
+3V3: 3V3.1; also elsewhere on the board
GND: GND.1; also elsewhere on the board
GND_ISO: GISO.1; also elsewhere on the board
UART_RX: RXD.1; also elsewhere on the board
UART_TX: TXD.1; also elsewhere on the board
VISO: VISO.1; also elsewhere on the board
