dnd-global/hardware-esp32-ethernet/(commit log)

2026-11-11 Rev B: KiCad project, fabrication files, schematic and tools
    ESP32-S3-WROOM-1 + W5500 Ethernet + isolated 3.3 V UART, 9-36 V input,
    2 layers, 80 x 66 mm. Not manufactured yet.
    - kicad/: board, 5-page schematic, symbol and footprint libraries
    - fab/: Gerber, BOM and CPL as prepared for JLCPCB assembly
    - docs/: schematic PDF and pictures
    - tools/: netlist table, schematic generator with a pin-by-pin check
    against the board, CPL check against the JLCPCB library footprints
    [esp32-eth-uart-module.kicad_pcb, esp32-eth-uart-module.kicad_sch, esp32.kicad_sch, ethernet.kicad_sch, gateway-s3-revb-bom.csv, nguon.kicad_sch, uart-cach-ly.kicad_sch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]
2026-11-12 Status light becomes an addressable RGB LED (WS2812B-2020-V6)
    LED2 was a white 0603 LED on GPIO38. It is now a WS2812B-2020-V6 (C52917434)
    supplied from +3V3, with its own 100 nF capacitor C36. R4 stays as the series
    resistor on the data line; the net LED2_A is renamed LED2_DIN.
    - board: LED2 replaced, C36 added, a few short tracks rerouted next to it.
    DRC as before (0 errors, 0 unconnected); isolation distance still 7.60 mm
    - fab: new Gerber, BOM (43 lines, 74 parts) and CPL; CPL check 74 parts, 0 failed
    - schematic regenerated: 81 parts, 53 nets and 256 pads agree with the board; ERC 0
    - pictures and README updated
    [esp32-eth-uart-module.kicad_pcb, esp32-eth-uart-module.kicad_sch, esp32.kicad_sch, gateway-s3-revb-bom.csv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]
2026-11-12 Status light goes back to the plain white LED
    This reverts commit 7078b4e. The WS2812B-2020-V6 was fine on paper, but JLCPCB
    lists it as a part that is hard to assemble and moisture sensitive (assembly
    difficulty high, MSL 5): it is left out of the assembly order unless it is
    ticked by hand, the order goes through an extra review, and assembly takes two
    more days. That is not worth it for a status light on the prototypes.
    Back to the state of cf0614b: a white 0603 LED (C2290) on GPIO38 through R4
    150R, and no C36. Board, fabrication files, schematic, pictures and README are
    the earlier ones, byte for byte.
    - schematic regenerated from the netlist table: identical files; 80 parts,
    53 nets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
    [esp32-eth-uart-module.kicad_pcb, esp32-eth-uart-module.kicad_sch, esp32.kicad_sch, gateway-s3-revb-bom.csv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]
